a-v-s/wireless_ac_power_switch/power_switch.kicad_pcb

## KiCad design power_switch.kicad_pcb (2024-09-11)

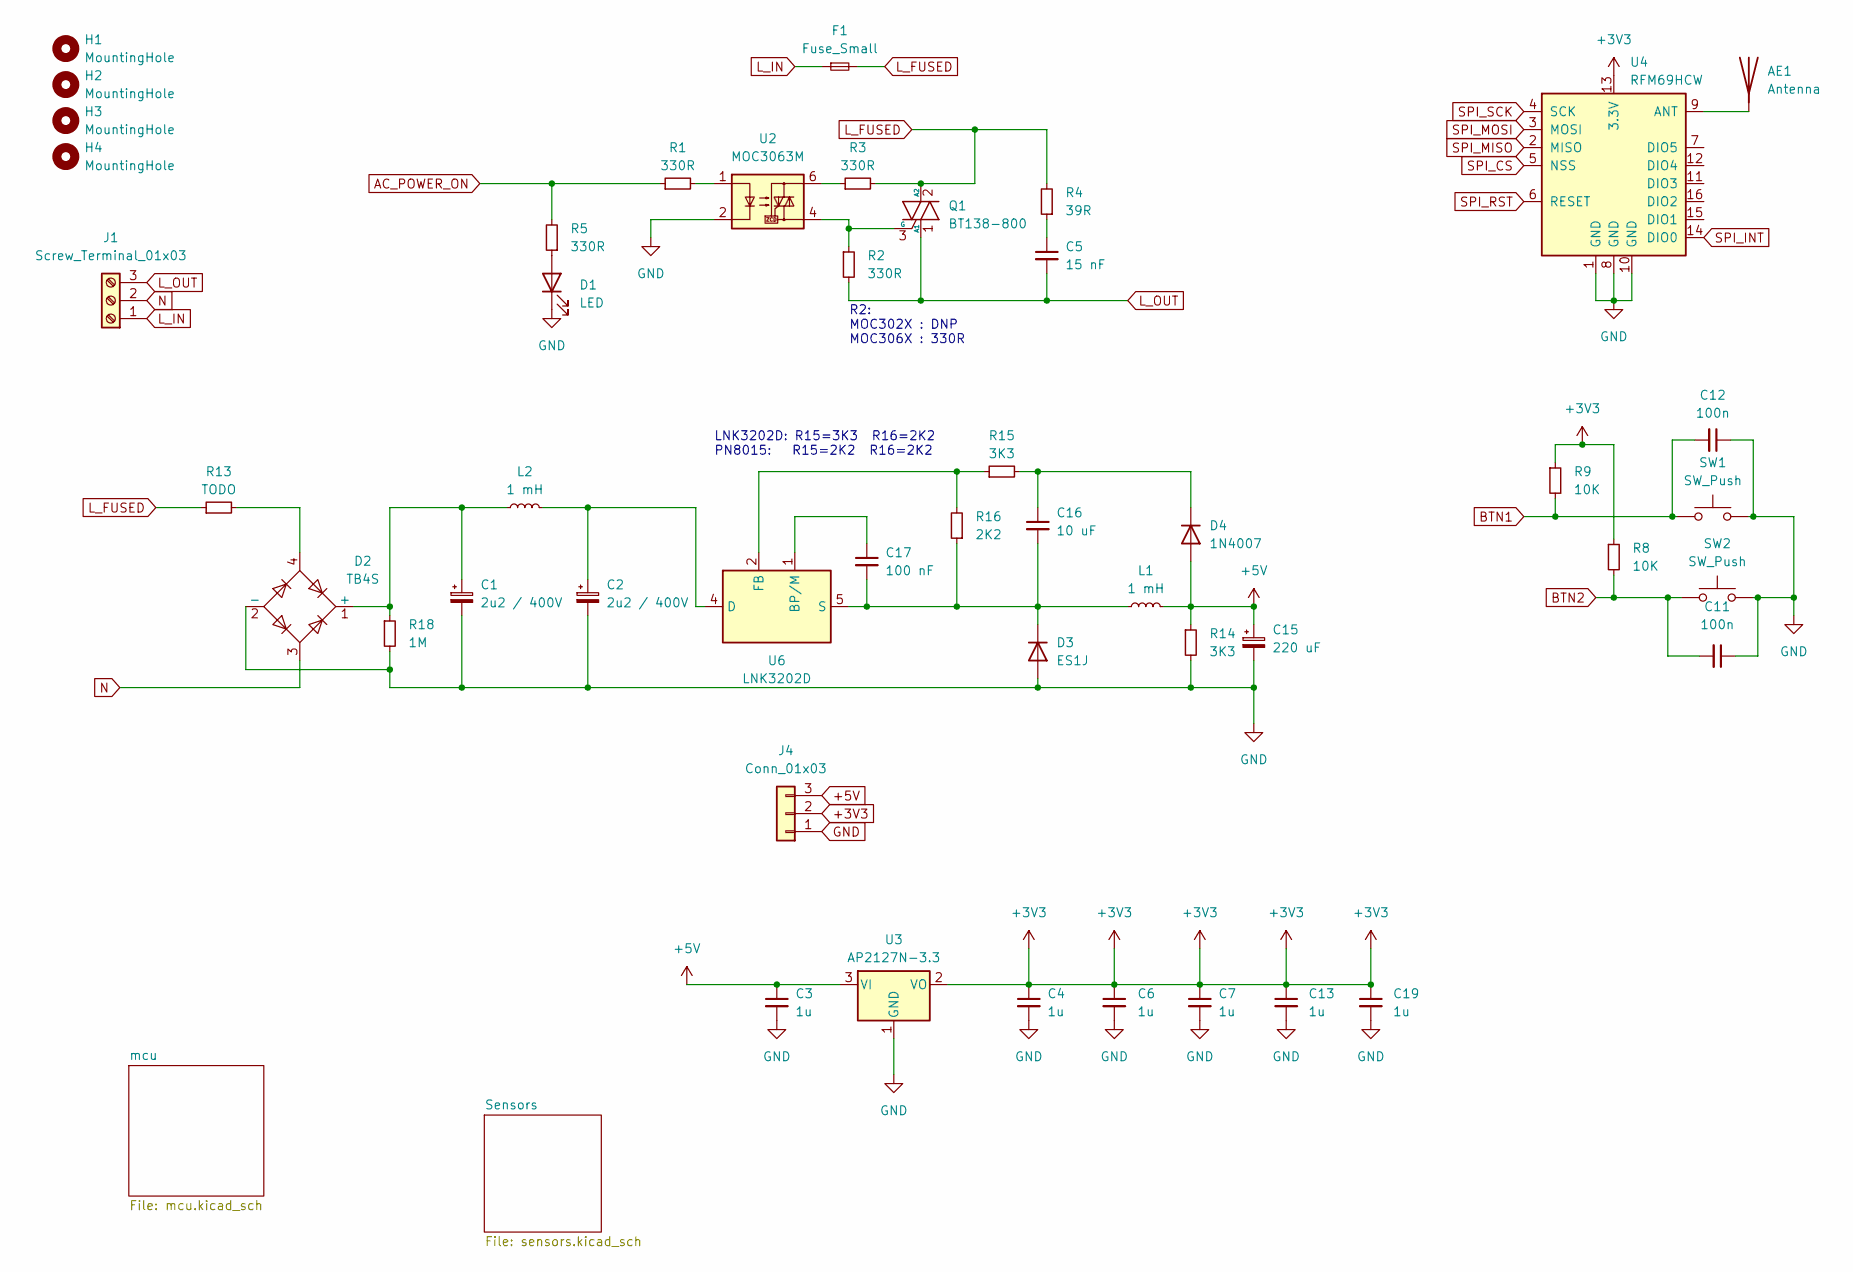
[picture p1: schematic power_switch.kicad_sch]

Parts:
AE1: Antenna; TestPoint_THTPad_D2.0mm_Drill1.0mm
C1, C2: 2u2 / 400V; CP_Elec_6.3x5.4
C3, C4, C6, C7, C13, C19: 1u; C_0805_2012Metric
C5: 15 nF; C_Rect_L11.0mm_W4.2mm_P10.00mm_MKT
C11, C12: 100n; C_0805_2012Metric
C15: 220 uF; CP_Elec_6.3x5.4
C16: 10 uF; C_0805_2012Metric
C17: 100 nF; C_0805_2012Metric
D1: LED; LED_0805_2012Metric
D2: TB4S; Diode_Bridge_Diotec_ABS
D3: ES1J; D_SMA
D4: 1N4007; D_SMA
F1: Fuse_Small; Fuseholder_Cylinder-5x20mm_Stelvio-Kontek_PTF78_Horizontal_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
H1, H2, H3, H4: MountingHole; MountingHole_2.2mm_M2
J1: Screw_Terminal_01x03; TerminalBlock_bornier-3_P5.08mm
J4: Conn_01x03; PinHeader_1x03_P2.54mm_Vertical
L1, L2: 1 mH; L_Changjiang_FNR8065S
Q1: BT138-800; TO-220-3_Vertical
R1, R5: 330R; R_0805_2012Metric
R2, R3: 330R; R_Axial_DIN0207_L6.3mm_D2.5mm_P10.16mm_Horizontal
R4: 39R; R_Axial_DIN0207_L6.3mm_D2.5mm_P10.16mm_Horizontal
R8, R9: 10K; R_0805_2012Metric
R13: TODO; R_Axial_DIN0309_L9.0mm_D3.2mm_P2.54mm_Vertical
R14, R15: 3K3; R_0805_2012Metric
R16: 2K2; R_0805_2012Metric
R18: 1M; R_1206_3216Metric
SW1, SW2: SW_Push; TS-1187
U2: MOC3063M; DIP-6_W7.62mm
U3: AP2127N-3.3; SOT-23
U4: RFM69HCW; HOPERF_RFM9XW_SMD
U6: LNK3202D; PowerIntegrations_SO-8C

Connections:
+3V3: C4.1, C6.1, C7.1, C13.1, C19.1, J4.2, R8.1, R9.1, U3.2 (VO), U4.13 (3.3V); also elsewhere on the board
+5V: C3.1, C15.1, D4.2 (A), J4.3, L1.2, R14.1, U3.3 (VI)
AC_POWER_ON: R1.1, R5.2; also elsewhere on the board
BTN1: C12.2, R9.2, SW1.2; also elsewhere on the board
BTN2: C11.2, R8.2, SW2.2; also elsewhere on the board
GND: C1.2, C2.2, C3.2, C4.2, C6.2, C7.2, C11.1, C12.1, C13.2, C15.2, C19.2, D1.1 (K), D2.2 (-), D3.2 (A), J4.1, R14.2, R18.2, SW1.1, SW2.1, U2.2, U3.1 (GND), U4.1 (GND), U4.8 (GND), U4.10 (GND); also elsewhere on the board
L_FUSED: F1.2, Q1.2 (A2), R3.2, R4.2, R13.1
L_IN: F1.1, J1.1
L_OUT: C5.2, J1.3, Q1.1 (A1), R2.2
N: D2.3, J1.2
unnamed: AE1.1 (A), U4.9 (ANT)
unnamed: C5.1, R4.1
unnamed: D1.2 (A), R5.1
unnamed: C1.1, D2.1 (+), L2.1, R18.1
unnamed: D2.4, R13.2
unnamed: C16.2, C17.2, D3.1 (K), L1.1, R16.1, U6.5 (S), U6.6 (S), U6.7 (S), U6.8 (S)
unnamed: C16.1, D4.1 (K), R15.2
unnamed: Q1.3 (G), R2.1, U2.4
unnamed: R1.2, U2.1
unnamed: R3.1, U2.6
unnamed: C17.1, U6.1 (BP/M)
unnamed: C2.1, L2.2, U6.4 (D)
unnamed: R15.1, R16.2, U6.2 (FB)
SPI_CS: U4.5 (NSS); also elsewhere on the board
SPI_INT: U4.14 (DIO0); also elsewhere on the board
SPI_MISO: U4.2 (MISO); also elsewhere on the board
SPI_MOSI: U4.3 (MOSI); also elsewhere on the board
SPI_RST: U4.6 (RESET); also elsewhere on the board
SPI_SCK: U4.4 (SCK); also elsewhere on the board

Notes on the sheet:
R2: MOC302X : DNP MOC306X : 330R
LNK3202D: R15=3K3 R16=2K2 PN8015: R15=2K2 R16=2K2

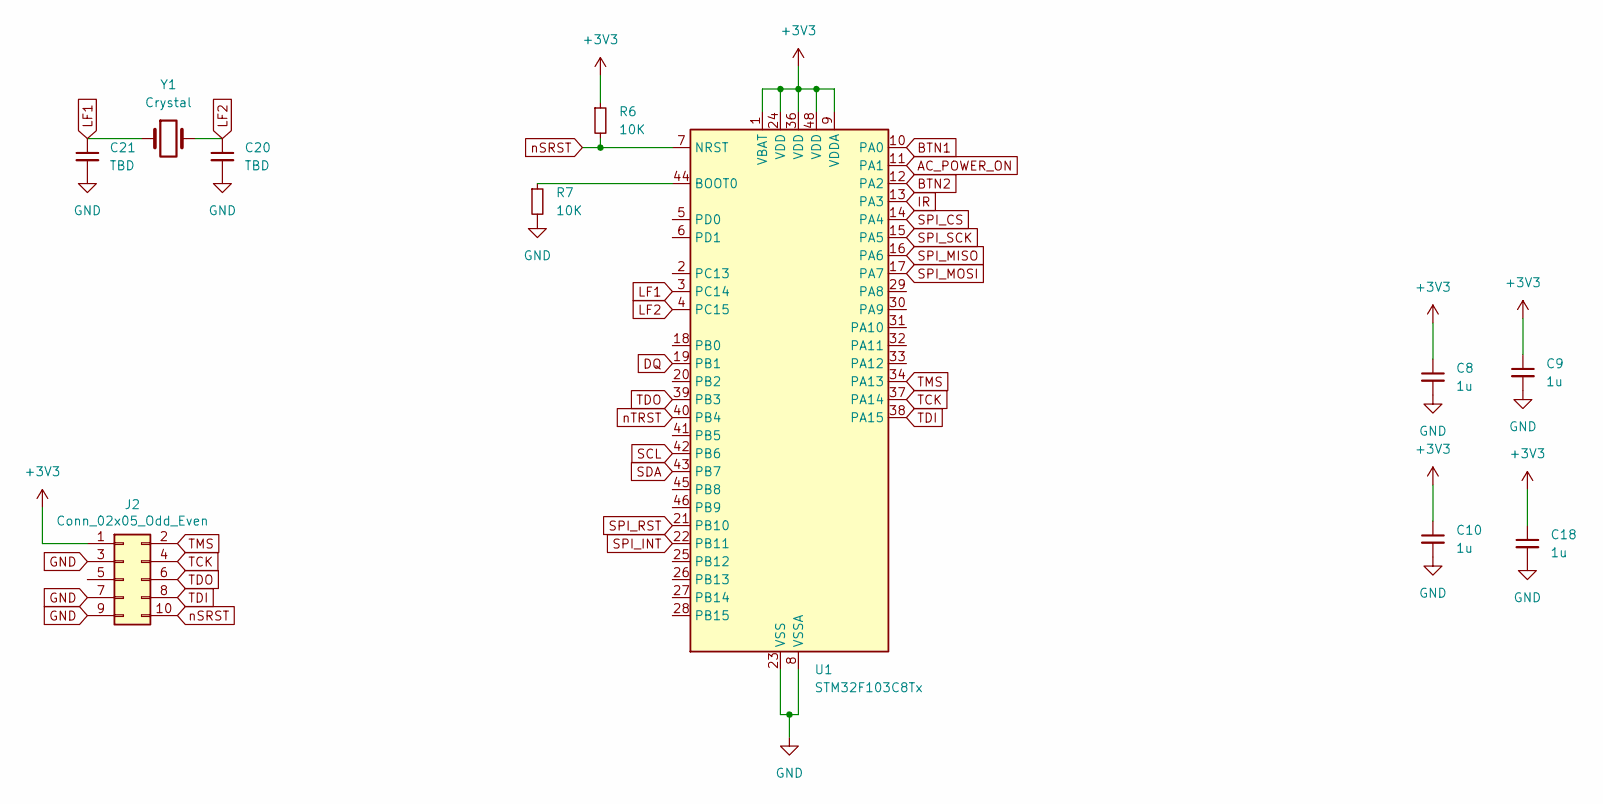
[picture p2: schematic mcu.kicad_sch]

Parts:
C8, C9, C10, C18: 1u; C_0805_2012Metric
C20, C21: TBD; C_0805_2012Metric
J2: Conn_02x05_Odd_Even; PinHeader_2x05_P1.27mm_Vertical_SMD
R6, R7: 10K; R_0805_2012Metric
U1: STM32F103C8Tx; LQFP-48_7x7mm_P0.5mm
Y1: Crystal; Crystal_SMD_3215-2Pin_3.2x1.5mm

Connections:
+3V3: C8.1, C9.1, C10.1, C18.1, J2.1, R6.1, U1.1 (VBAT), U1.9 (VDDA), U1.24 (VDD), U1.36 (VDD), U1.48 (VDD); also elsewhere on the board
AC_POWER_ON: U1.11 (PA1); also elsewhere on the board
BTN1: U1.10 (PA0); also elsewhere on the board
BTN2: U1.12 (PA2); also elsewhere on the board
DQ: U1.19 (PB1); also elsewhere on the board
GND: C8.2, C9.2, C10.2, C18.2, C20.2, C21.2, J2.3, J2.7, J2.9, R7.2, U1.8 (VSSA), U1.23 (VSS), U1.35 (VSS), U1.47 (VSS); also elsewhere on the board
IR: U1.13 (PA3); also elsewhere on the board
LF1: C21.1, U1.3 (PC14), Y1.1
LF2: C20.1, U1.4 (PC15), Y1.2
unnamed: R7.1, U1.44 (BOOT0)
SCL: U1.42 (PB6); also elsewhere on the board
SDA: U1.43 (PB7); also elsewhere on the board
SPI_CS: U1.14 (PA4); also elsewhere on the board
SPI_INT: U1.22 (PB11); also elsewhere on the board
SPI_MISO: U1.16 (PA6); also elsewhere on the board
SPI_MOSI: U1.17 (PA7); also elsewhere on the board
SPI_RST: U1.21 (PB10); also elsewhere on the board
SPI_SCK: U1.15 (PA5); also elsewhere on the board
TCK: J2.4, U1.37 (PA14)
TDI: J2.8, U1.38 (PA15)
TDO: J2.6, U1.39 (PB3)
TMS: J2.2, U1.34 (PA13)
nSRST: J2.10, R6.2, U1.7 (NRST)
nTRST: U1.40 (PB4)

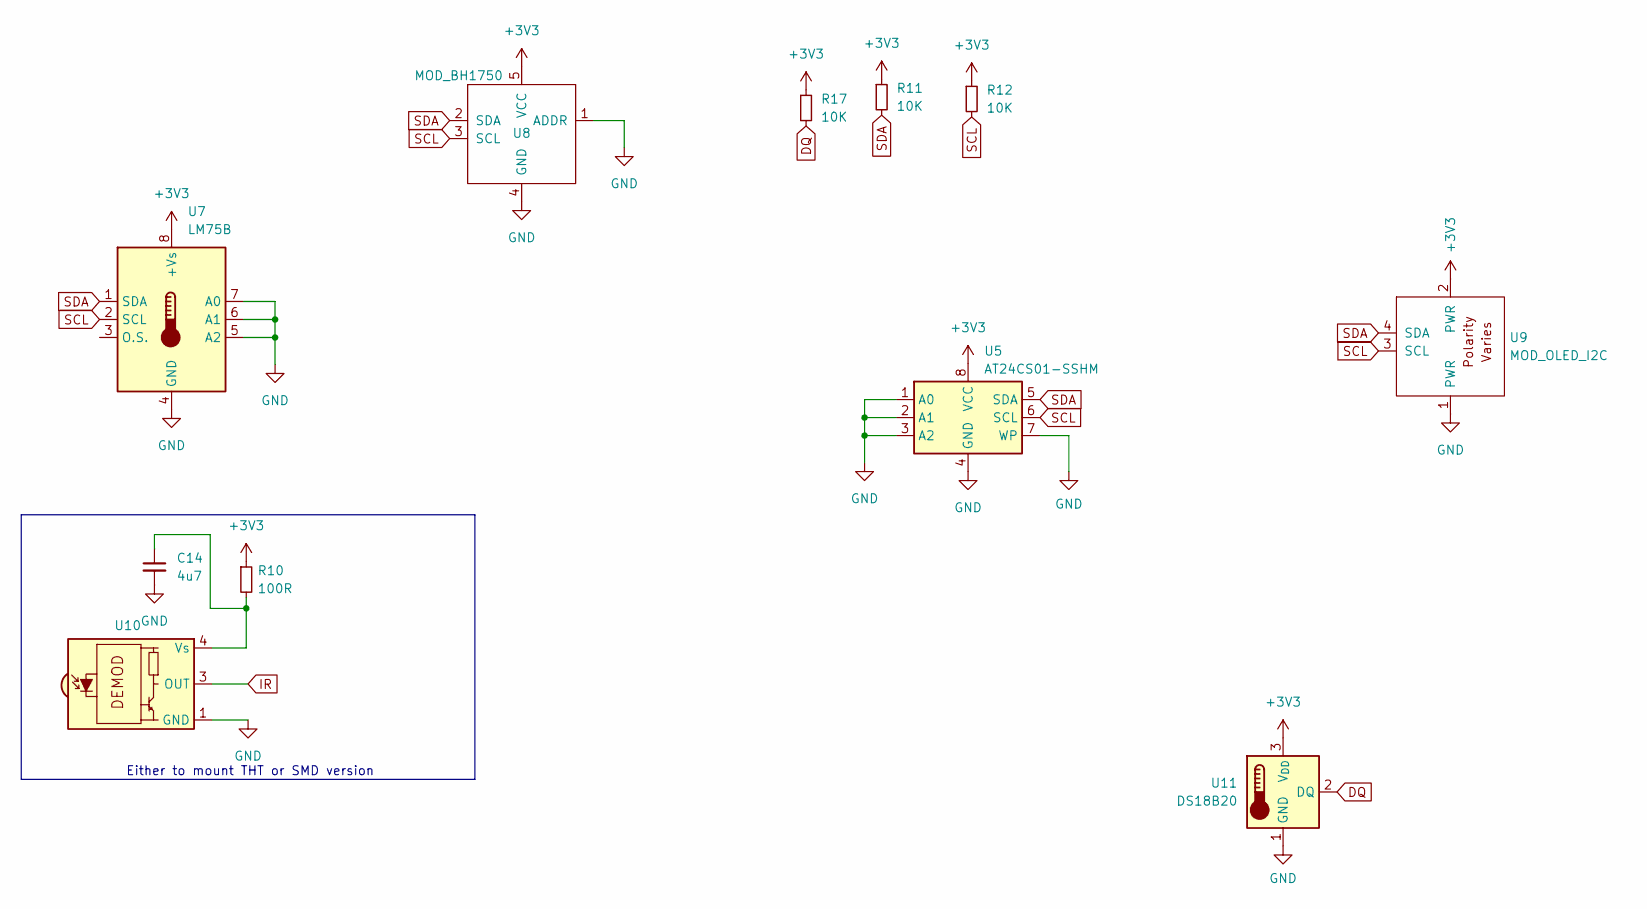
[picture p3: schematic sensors.kicad_sch]

Parts:
C14: 4u7; C_0805_2012Metric
R10: 100R; R_0805_2012Metric
R11, R12, R17: 10K; R_0805_2012Metric
U5: AT24CS01-SSHM; SOIC-8_3.9x4.9mm_P1.27mm
U7: LM75B; SO-8_3.9x4.9mm_P1.27mm
U8: MOD_BH1750
U9: MOD_OLED_I2C; MOD_OLED_I2C_128x64_0.96
U10: IRM-H6XXT-TR2
U11: DS18B20; TO-92_Inline

Connections:
+3V3: R10.1, R11.1, R12.1, R17.1, U5.8 (VCC), U7.8 (+Vs), U8.5 (VCC), U9.2 (PWR), U11.3 (V_{DD}); also elsewhere on the board
DQ: R17.2, U11.2 (DQ); also elsewhere on the board
GND: C14.2, U5.1 (A0), U5.2 (A1), U5.3 (A2), U5.4 (GND), U5.7 (WP), U7.4 (GND), U7.5 (A2), U7.6 (A1), U7.7 (A0), U8.1 (ADDR), U8.4 (GND), U9.1 (PWR), U10.1 (GND), U10.2 (GND), U11.1 (GND); also elsewhere on the board
IR: U10.3 (OUT); also elsewhere on the board
unnamed: C14.1, R10.2, U10.4 (Vs)
SCL: R12.2, U5.6 (SCL), U7.2 (SCL), U8.3 (SCL), U9.3 (SCL); also elsewhere on the board
SDA: R11.2, U5.5 (SDA), U7.1 (SDA), U8.2 (SDA), U9.4 (SDA); also elsewhere on the board

Notes on the sheet:
Either to mount THT or SMD version

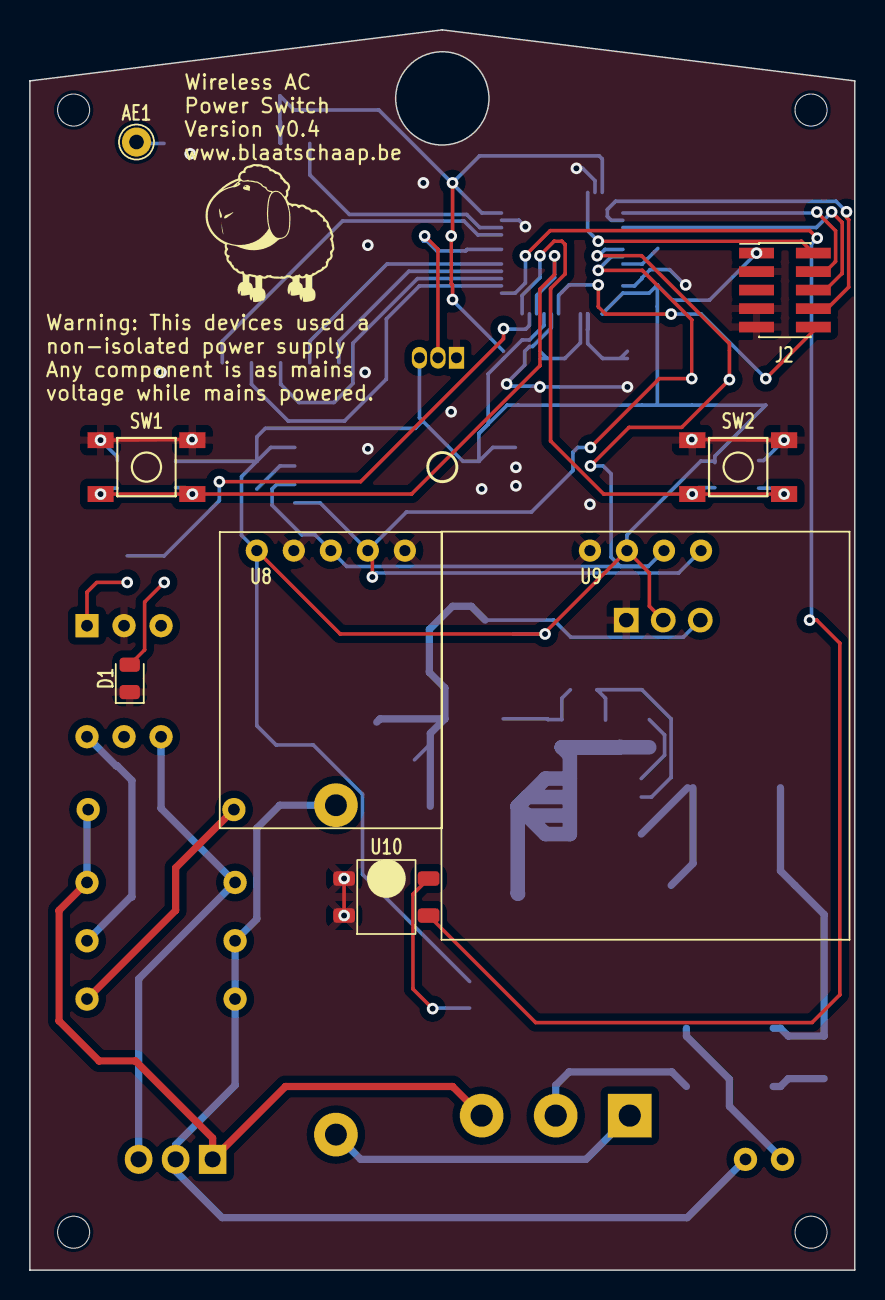
[picture p4: board power_switch.kicad_pcb from above]

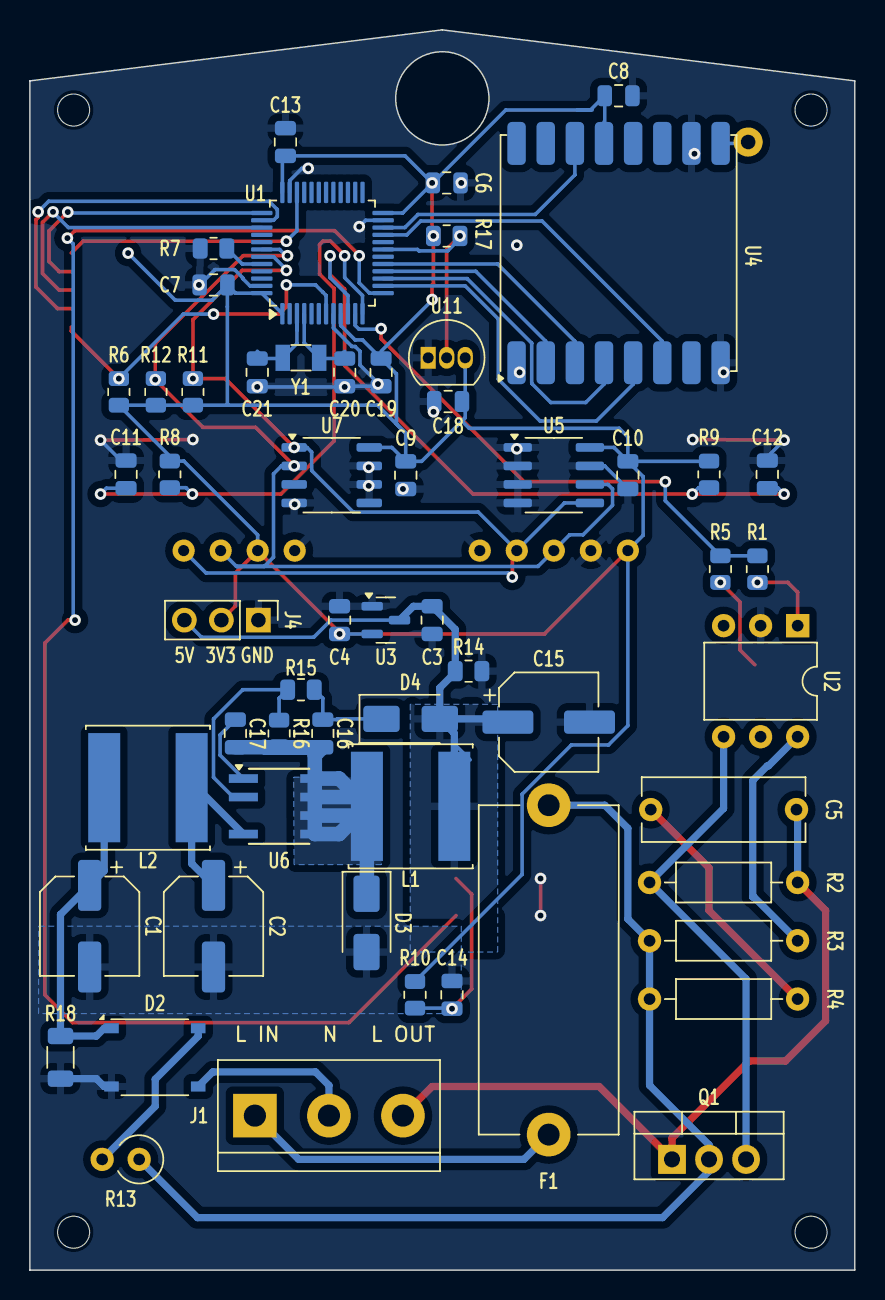
[picture p5: board power_switch.kicad_pcb from below]

Board: 2 copper layers, 56.6 x 85.1 mm, 69 parts (57 on the bottom side), 42 nets.
