a-v-s/wireless_ac_power_switch/(commit log)

2023-12-31 RF AC Power Switch v0.1
    [mcu.kicad_sch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]
2024-01-12 Changes from initial results (dimentions, foorprints)
    [power_switch.kicad_pcb]
2024-03-01 so far, changes to be made to schematic again
    [power_switch.kicad_pcb]
2024-03-01 adding display
    [power_switch.kicad_pcb, power_switch.kicad_sch, sensors.kicad_sch]
2024-03-03 r/c with ir
    [power_switch.csv, power_switch.kicad_pcb, sensors.kicad_sch]
2024-03-18 Add i2c header, remove solder jumpers for display polarity
    [mcu.kicad_sch, power_switch.kicad_pcb, power_switch.kicad_sch, sensors.kicad_sch]
2024-04-06 Add missing values
    [mcu.kicad_sch, power_switch.kicad_sch]
2024-09-02 acdc wip
    [mcu.kicad_sch, power_switch.kicad_pcb, power_switch.kicad_sch, sensors.kicad_sch]
2024-09-06 so far
    [power_switch.kicad_pcb]
2024-09-06 one can go
    [mcu.kicad_sch, power_switch.kicad_pcb, sensors.kicad_sch]
2024-09-06 Working on flipping all
    [mcu.kicad_sch, power_switch.kicad_pcb, power_switch.kicad_sch]
2024-09-07 initial routing done
    [mcu.kicad_sch, power_switch.kicad_pcb, power_switch.kicad_sch, sensors.kicad_sch]
2024-09-08 Adding a bleeding resistor
    [power_switch.kicad_pcb, power_switch.kicad_sch, sensors.kicad_sch]
